HetorusNL/isstt-impro-announcer/docs/reference/impro-desk.jpg

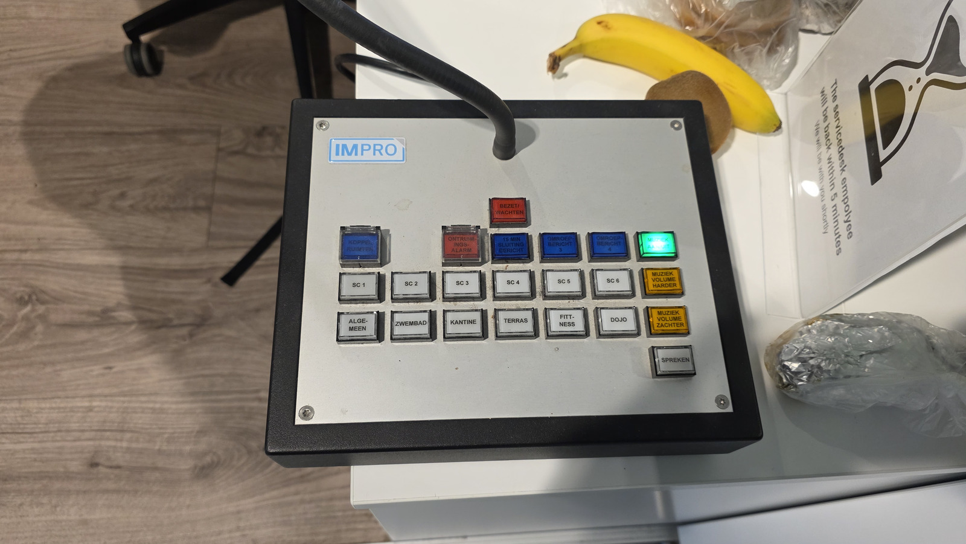
docs/reference/impro-desk.jpg
