HetorusNL/isstt-impro-announcer/hardware/cad/README.md

# Servo rig parts

Parametric OpenSCAD sources for the rig that presses buttons on the IMPRO desk from the outside. The numbers come from one file, `params.scad`. Most desk numbers are estimates from the photo, marked `// ESTIMATE` with what to measure. Change them there, re-render, reprint.

Render a part with `openscad -o part.stl part.scad`. STLs are not committed. Each part file lays its part in print orientation.

## Parts

| File | Part | Print |
|---|---|---|
| `edge_clamp.scad` | Padded clamp jaw, for both case sides (the same part turned 180 degrees) | 2 |
| `servo_carriage.scad` | Module carriage: bolts to a rail face, keyed in the slot | 4 |
| `servo_bracket.scad` | Module bracket: holds the servo and plunger guide, slides up and down the carriage | 4 |
| `servo_cam.scad` | Cam on the servo horn | 4 |
| `servo_plunger.scad` | Plunger between cam and button | 4 + spare |
| `tensioner_block.scad` | Tensioner block on the rail outside each post, for both sides (the same part turned 180 degrees) | 2 |
| `tensioner_pad.scad` | Tensioner pressure pad, bridges the slot in the post | 2 |
| `tensioner_collar.scad` | Stop collar under the push bolt head, sets the squeeze | 2 + spare |
| `squeeze_gauge.scad` | Go/no-go feeler gauge for the post gap, one for both sides | 1 |
| `end_cap.scad` | Press-fit end cap: 2 rail ends, 2 post bottoms | 4 + spare |
| `speaker_cradle.scad` | ER-151 cradle, arm and fixed half of the tube clamp | 1 |
| `speaker_clamp_cap.scad` | Removable half of the tube clamp | 1 |
| `../replica/replica_panel.scad` | Replica of the desk top | 1 |
| `../replica/test_button_plunger.scad` | Test button cap and snap stem | 4 |
| `../replica/test_button_leaf.scad` | Test button leaf spring | 4 + spare |
| `../replica/alarm_cover.scad` | Dummy flip cover | 2 |
| `frame_assembly.scad` | The whole rig. Not printed: a picture and the safety checks | - |
| `params.scad`, `lib.scad` | All dimensions; shared geometry | - |

## Print settings (Bambu Lab H2D)

| Setting | Structural parts (clamps, carriages, brackets, tensioner blocks and pads) | Other parts |
|---|---|---|
| Material | PETG (PLA also works, but creeps under the clamp load in a warm room) | PETG or PLA |
| Layer height | 0.2 mm | 0.2 mm |
| Walls | 5 | 3 |
| Top and bottom layers | 6 | 4 |
| Infill | 40 % gyroid | 15 % |
| Supports | None. See the tensioner block note | Only for `speaker_cradle.scad`, under the cups |

Print the tensioner block standing on its outer end, as its file lays it out. Slicing it shows three short bridges and no other overhang: the shoulder over the head slot (10.7 mm), the ceiling of the T-nut pocket (10.6 mm), and the top of the horizontal rail bolt hole (about 6 mm). The shoulder carries the push load, and it bends along its bridge strands, which is the strong direction. It has a 0.2 mm skin closing the bolt hole so the bridge prints whole: drill it out with a 5.5 mm drill (`m5_clear`). Check the collar thickness with calipers: it should be 2.2 mm, at 0.2 mm layers.

Print the gauge as laid out, so the blade thickness is in the print plane. Check both blades with calipers: go 10.45 mm, no-go 11.05 mm. If one is more than 0.1 mm off, sand it or reprint.

Print the replica open side down. The plate bridges between the ribs. The leaf springs need 100 % infill and must lie flat, so the leaf thickness is a whole number of layers. Print the plungers and the cam with 5 walls: they carry the press force.

## Cutting the extrusion

From the 1 m 2020 profile, with the default parameters:

- 1 rail, `rail_len` = **325.4 mm**
- 2 posts, `post_len` = **90.4 mm** each

That leaves about 490 mm spare. These lengths change when the desk is measured: run `openscad -o /tmp/a.stl frame_assembly.scad` and read them from the `ECHO` lines. Cut after measuring the desk.

## Assembly

**The T-nuts are slide-in: they only enter from a profile end.** Insert every nut you need, M5 and M4, **before** fitting corner brackets or end caps. If you miss one, the joint has to come apart.

Count of M5 slide-in nuts, with the default four modules:

| Where | Slot | Nuts |
|---|---|---|
| Rail | Back face (towards the SC row) | 3, one per SC module |
| Rail | Front face (towards SPREKEN) | 1 |
| Rail | Bottom slot, outermost at each end, for the tensioner blocks | 2 |
| Each post | Inner face, for the clamp jaw | 2 per post, so 4 |
| Module carriages | Pocket for the height bolt | 4 |
| Tensioner blocks | Pocket for the push bolt | 2 |
| Speaker clamp | Pockets | 2 |
| **Total** | | **18 of the 20 ordered** |

The corner brackets bring their own hardware, which is not in this count: M4x8 bolts and M4 slide-in nuts, 2 of each per bracket, so **8 M4 nuts on top of the 18 M5**. One nut of each bracket goes in the rail's bottom slot and the other in a post's side slot. Insertion order per slot:

| Slot | Enter from | Order |
|---|---|---|
| Rail bottom, from each end | That rail end | Inner bracket M4, then outer bracket M4, then the tensioner M5 last, so it is outermost |
| Post inner face (the jaw side) | Post bottom | Bracket M4 first, so it is nearest the rail, then the 2 jaw M5 |
| Post outer face | Post bottom | Bracket M4 only |

Use M5x10 for every printed part, including the tensioner. M5x8 leaves too little thread in the T-nut there.

Cut these pads from the sheet, slightly oversize so they press in:

| Pad | Size | Quantity |
|---|---|---|
| Jaw side | 30 x 22 mm | 2 |
| Under the lip | 30 x 7 mm | 2 |
| Plunger tip dot | 5 x 5 mm, press fit in the 4.5 mm recess, stands 1 mm proud | 4 |

The side pads and tip dots stay in by the press fit. The under-lip pad hangs upside down while the frame is lowered: a dab of removable tack on the pad-to-jaw side only is fine. Never put anything on the side that faces the desk.

1. Cut the rail and posts, then fit the nuts above, including the 8 M4 bracket nuts.
2. Join each post's top end to the rail's bottom face with 2 corner brackets, one on each side of the post, with the M4x8 bolts. Tighten the bolts into the post. Leave the bolts into the rail loose, so the posts slide along the rail. The bracket's centring lips sit in the slot, so a loose bracket still slides along the rail.
3. Press the end caps into the rail ends and post bottoms.
4. Bolt a jaw to each post's inner face with 2 M5x10, key in the slot, then push in the pads. No adhesive. The pad covers the bolt heads, so take it out to adjust the jaw.
5. Tensioner, one per side: drill out the skin in the shoulder hole. Slide a T-nut into the block's pocket. Put the stop collar on an M5x10 under its head, and thread the bolt through the shoulder into the nut. Put the pad's stub in the socket. Bolt the block to the rail's bottom slot with an M5x10, key in the slot, with a key's long arm up through the head slot. Keep it loose for now.
6. Set the squeeze, without the modules. See "Setting the squeeze".
7. Module: trim a stock single horn to `horn_stub` (7.5 mm from the axis). Drop the plunger into the guide from above, with the dot in its tip. Fit the servo from the back with the ears on the back face and the servo's own screws. Fit the horn and the cam with the horn screw. If that screw is too short with the cam fitted, use M2x8: check on one servo first.
8. Carriage on rail: M5x10 into a T-nut, key in the slot. Bracket on carriage: M5x10 through the slot into a T-nut in the pocket. The slot also gives a hex key access to the rail bolt, so a module can slide along the rail without taking it apart.
9. Slide each module over its button. With the eccentric pointing up, which is the cam's clear position, adjust the height so that the plunger rests on the cap with about 1 mm gap to the cam. Do not set this at servo angle 90: see "Cam calibration".

Module height adjustment is +6 mm and -3 mm: further down, the guide touches the cap.

Modules reach rows 1 and 3 on any column, so the SC row and the SPREKEN row. They cannot reach row 2 (ALGEMEEN to MUZIEK ZACHTER), because the rail runs directly above it. `params.scad` fails the render if you list a button there.

## Setting the squeeze

The clamping force comes from compressing the side pads by `pad_squeeze`, **0.8 mm per side**, which is one full turn of the push bolt. The pad is hidden, so its compression cannot be measured. The stop collar sets it instead, from a defined start, and a gauge checks the result.

| Post inner face to case wall, each side | Meaning |
|---|---|
| 11.5 mm | Pad just touching: the start |
| **10.7 mm** | **Target: the collar has seated** |
| 10.0 mm | Jaw plastic touches the case. **Never go this far: it can mark the desk.** |

These follow the measured `case_w`, and `frame_assembly.scad` echoes them.

1. Lower the frame over the desk with the lips resting on the rim. The bolts into the rail stay loose, on all 4 corner brackets. The bracket's centring lips sit in the slot: a loose bracket still slides along the rail, which steps 3 and 5 rely on.
2. Back off each push bolt by at least one full turn from the collar, and push the pad fully into its block.
3. Bring each post inward by hand until its pad just touches the case wall: the post stops sliding freely. Do not press into the foam.
4. Slide each block along the rail until its pad touches the post, without moving the post. Tighten the block's rail bolt with the long arm of a 3 mm hex key, up through the head slot. The handle swings below the block.
5. Turn the push bolts in with the same key, from outside, along the rail. Take turns, a quarter turn per side, until each head seats on its collar and stops. From contact that is one turn, 0.8 mm. If you backed off further, the first turns do nothing, and the result is the same. A loose post tilts, because the bolt pushes above the pad, so keep the posts upright.
6. Lock the corner bracket bolts into the rail, with the key that fits the bracket bolts: they are M4x8, and the size is unconfirmed, probably 2.5 mm if button head and 3 mm if socket head. Reach the outer bracket's bolts with the key's short arm, from below, through the gap above the block's arm, with the long arm swinging out to the front or back. The CAD draws the bracket as a cube, so the real access may instead be from the side or through the window in the sloped face.
7. Check with the gauge at the front and back edge of each post. Hold it by the bar, flat face against the case wall, and push a blade gently up from below, between the case wall and the 5 mm of post that sticks out below the jaw. Turn it around for the other side.
   - **The GO blade must fit.** If it does not, the jaw plastic is too close: loosen the brackets and start again from step 2.
   - **The NO blade must not fit.** If it does, the pad is not compressed enough: start again from step 2.

If locking moved a post, the gauge shows it. Loosen, correct and measure again. If you have calipers that reach, you can also check the spacing of the post inner faces, 202.4 mm with the estimated `case_w`, just above the jaws and before fitting the modules. That check is optional.

The block only pushes, and the collar touches only the block and the bolt, so the screw cannot pass the limit however hard you turn it, but only with the collar fitted and as long as the start was right. Never run the push bolt without its collar: the collar is what stops the jaw plastic reaching the case.

**Foam take-up.** The tensioner stays fitted. If the foam relaxes, repeat the whole procedure from step 1, with the modules still on. The collar then sets 0.8 mm from the pad's new contact. Do not use a thinner collar: that is the one way to overshoot. If the GO blade no longer fits after this, the pad has taken a permanent set: replace it.

## Cam calibration

Fit the cam with the eccentric horizontal at servo angle 90 (the groove on the cam's face marks the eccentric). **Fit all modules with the eccentric on the same side**: neighbouring cams then never swing towards each other. Then calibrate with the GUI on the real button. Expect rest at about 135 and press at about 65; the numbers mirror depending on which side the eccentric points.

**Before the first connect with modules on the desk, set `rest` to about 135 and `press` to a safe angle close to it, for example 120, in `config.toml`, and keep the plungers out until one connect with that rest has happened.** The firmware also drives the servos to the rest in its flash at power-on, before the host sends any config (README in the repo root, "Last bench step"). At rest 90 the cam holds the plunger about 1.5 mm into the button's travel. The host sends the rest angle on every connect, and the failsafes go to it, so a wrong rest can keep a button pressed. The angles in `config.example.toml` (rest 90, press 60) are placeholders and do not suit the cam.

**Stop at the angle where the button just bottoms out.** Going further only makes the servo push against the stop and draw current. The servo can push about 50 N at the press angle, which is more than the pads hold down, so overdriving the press angle lifts the frame.

## The button pusher: why a cam

The brief allows a horn or an arm. A swinging arm has two problems at this pitch:

- With a module offset by an arm length, the arm of one module reaches the shaft of the next once the arm is longer than about 11 mm, and the stock horn is longer than that.
- With an arm that short, the pushing finger has to hang down far enough to clear the servo body, and it then slides 5 to 6 mm across the cap during the press.

So each module sits centred on its own column, and a cam on the horn pushes a plunger straight down in a guide. The cam's eccentricity (`arm_len`) is the effective arm length. This also takes up less room and gets a much better force margin.

## Stiffness and force

The requirement: holding SPREKEN, deflection < 0.5 mm, servo force margin at least 2x at the arm length used.

### Force margin at the default arm length

MG90S stall torque is about 2.2 kg.cm at 5 V (ESTIMATE). 2.2 kg.cm is 215.7 N.mm.

Press force 3 N (ESTIMATE) at arm length 2.5 mm, plus cam friction (mu 0.3 at radius 6.75 mm, ESTIMATE):

- Lever: 3 N x 2.5 mm = 7.5 N.mm
- Friction: 3 N x 0.3 x 6.75 mm = 6.1 N.mm
- Required torque: 13.6 N.mm

**Margin: 215.7 / 13.6 = 15.9x.** At 1.8 kg.cm, the low end of the listings, it is 13.0x. The 2x limit is reached at a press force of about 24 N. `params.scad` fails the render if the margin drops below 2.

### Deflection while holding SPREKEN

Estimates with press force 3 N; printed PETG E = 2000 N/mm2. The real test is the stiffness check under "Manual checks".

| Item | Calculation | Deflection |
|---|---|---|
| Rail bending | 2020, simply supported over 222.4 mm, load at the middle (worst case): F L^3 / 48 E I | 0.0014 mm |
| Module lower walls | Moment 3 N x 12 mm over 20 mm, two walls 2 x 10 mm | 0.012 mm |
| Module upper U section | Moment 3 N x 12 mm over 39 mm, shelf to height bolt, walls 2 x 11 mm (conservative: the plate also bears on the carriage) | 0.018 mm |
| Plunger compression | 3 N over 6 x 6 mm, 18.5 mm long | 0.001 mm |
| Pad shear | 1.5 N per side over 651 mm2 of 3 mm EVA, G = 0.5 N/mm2 (ESTIMATE) | 0.014 mm |
| **Sum** | | **about 0.05 mm** |

The bolted joints are not in that sum. Even at several times this figure, the budget is well inside 0.5 mm. Gear backlash at the cam is also small: 1 degree at 2.5 mm is 0.04 mm, against 0.35 mm on a 20 mm arm. The load keeps it taken up during a hold.

How the design gets there:

- **Both sides clamped:** the rail spans between two posts, one on each side of the case, so it never acts as a cantilever.
- **Extrusion against the press force:** the reaction pulls straight up the rail's cross-section and along the posts' length. A 2020 profile is square, so its strong axis is both axes (ESTIMATE I = 6900 mm4). No bending reaches a weak section. A printed rail would be many times less stiff.
- **Generous module walls and ribs:** each bracket is a U section whose side walls run from the plunger guide up past the rail, deep behind the servo plate. The servo plate carries the load in its own plane, and the screws in shear, not pull-out.
- **Metal joints:** 2 corner brackets per post.

### Clamp grip

The press force pushes the frame up, and friction at the pads holds it down. At 25 % compression the EVA gives about 0.05 N/mm2 (ESTIMATE, low end) over 651 mm2, so 33 N per side. With mu 0.5 (ESTIMATE) both pads hold 33 N. That is 11x the SPREKEN load, and 2.7x with all four buttons held at once, which is the safe upper limit: the normal peak is one button. The frame's own weight adds to this, and the lips stop it going down. `frame_assembly.scad` fails the render below 2x.

The asserts in `frame_assembly.scad` only run when that file is rendered, so render it before reprinting anything.

These figures are estimates, so the real test is the pull check under "Manual checks".

## Safety: covered buttons

*Ontruimingsalarm* and *Koppel ruimtes* have keep-out volumes in `params.scad`. They follow `alarm_xy` and `koppel_xy`, so a measured position moves the safety volume. They cover the flip cover, its swing, side room for fingers and hand room up to 120 mm. `frame_assembly.scad` shows them as translucent volumes and fails the render if the rail, a post, a clamp, a tensioner or a module enters one. `params.scad` also fails the render if a covered button is listed as actuated. Nothing may ever be mounted over them.

The nearest part is the SC 3 module, directly in front of the alarm. Its guide ends about 6 mm in front of the cover's lip. `lip_clearance_min` (4 mm) is only the minimum clearance from any part to the lip. It is not room for a finger: the hand has to come from above, over the rail and the modules, and down into the volume above the cover. None of this is proven. The asserts only check that parts stay out of a box, so only the cover check under "Manual checks" can show that the alarm is reachable.

If a measured `pitch_y` or `alarm_xy` trips the assert, the clearance is `pitch_y - cover_d / 2 - sleeve_half`. Measure `cover_d` first, then reduce `guide_wall` (down to about 1.6 mm) for a narrower nose. Don't just lower `lip_clearance_min`.

## Speaker holder

The ER-151 slides into the cradle from the open side, then a strap holds it. The strap goes through the slots in the beam and around the prism outside the driver area. Any velcro cable tie or elastic strap that fits works: the slots are 3 x 18.8 mm.

- The driver face points at the mic head, at `mic_dist` (default 40 mm, spec 30 to 50 mm).
- `mic_offset` is 0 for the mic centred between the drivers, or 27.5 for the mic in line with one driver.
- The cups only hold the prism ends, outside the drivers. The end walls have windows, and the sloped faces stay free, so the USB and 3.5 mm plugs fit wherever they turn out to be.
- The tube clamp takes `tube_d` plus a rubber or EVA lining of `tube_lining` per side. Tighten by hand: it must not mark the gooseneck.

**Check first:** the holder and speaker hang on the gooseneck, and a gooseneck may sag under the speaker. See the checklist.

## Test button

Choice: a **printed leaf spring**, no parts to buy. The cap sits on a split stem with snap barbs under the panel. The stem presses on a leaf whose root pushes into a tunnel under the panel.

The leaf is a cantilever, `k = E b t^3 / (4 L^3)`. `params.scad` calculates its thickness from `btn_force`, rounded to whole 0.2 mm layers. The default gives t = 1.4 mm and 3.1 N at full travel, but only if printed PETG really has E = 2000 N/mm2, which is an estimate.

**Calibrate it after printing:** cup + water/coins on the cap until the cap lands, then weigh. If it is off, change `tb_print_E` and reprint the leaf.

The cap landing on the panel is the hard stop, and it represents the button being actuated. Check it with a strip of paper under the cap: when the strip is trapped, the button is fully pressed.

## Manual checks, left for Tim

- [ ] Print the parts and the replica.
- [ ] Calibrate the test button force (see above).
- [ ] Measure the desk and replace every `ESTIMATE` in `params.scad` that matters for fit. Reprint.
- [ ] Check T-nut and servo fits on one printed carriage and bracket before printing all four.
- [ ] Render `frame_assembly.scad` before reprinting anything, so the safety and hold-down asserts run.
- [ ] **Hex key:** when the corner brackets arrive, fit one real bracket and try the key that fits the bracket bolts on its rail bolt, with a printed block in place, before printing all blocks. The real access may be from the side or through the window in the sloped face. The CAD draws the bracket as a cube, so the 2.8 mm `bracket_key_clearance` is an estimate.
- [ ] **Squeeze:** set and check it as in "Setting the squeeze". Jaw plastic never touches the case.
- [ ] **Case wall:** confirm the case side wall is flat and vertical where the pads sit.
- [ ] **Stiffness:** on the replica, hold SPREKEN with the servo at its press angle for 60 s. The paper strip stays trapped the whole time, and deflection measured at the rail or module is below 0.5 mm (feeler gauge or dial).
- [ ] **Force margin:** check again with the measured press force. Margin = stall torque / (force x (`arm_len` + 0.3 x `cam_r`)), at least 2x.
- [ ] **Hold-down:** on the real desk, pull the frame upward with a spring scale or a weighed pull, at least 2x the measured press force. It must not lift or slip. Repeat after the rig has been clamped for some hours.
- [ ] **Cover, replica:** with the rig on the replica, open the dummy flip cover by hand on the alarm and on Koppel ruimtes.
- [ ] **Cover, real desk:** with the full rig fitted, including speaker and mic, sit at the operator position. Using one hand, open the real cover and press the button. It passes only if you can do this. If it fails, the rig does not go in service like this. Fix it first: a narrower or chamfered nose on the SC1 and SC3 modules, or a lower wall of modules.
- [ ] **Hand volume:** the speaker, holder and mic stay out of the hand volume above both covers, also after any sag. Record the allowed mic position. Servo leads follow the routing rule in `wiring.md`.
- [ ] **Speaker:** mount the holder on the gooseneck and check it does not sag. Check the distance to the mic with a ruler.
