HetorusNL/isstt-impro-announcer/firmware/PROTOCOL.md

# Servo firmware protocol (NUCLEO-F767ZI / NUCLEO-F746ZG)

Build: `pio run -d firmware -e nucleo_f767zi` (or `-e nucleo_f746zg`); flash with `pio run -d firmware -e <env> -t upload`.

## Serial

- `Serial` at 115200 baud, 8N1. In the STM32duino core both Nucleo-144 variants
  (`variant_NUCLEO_F767ZI.h`, `variant_NUCLEO_F7x6ZG.h`) set `SERIAL_UART_INSTANCE 3`
  (USART3, PD8/PD9), which is wired to the ST-Link virtual COM port (`/dev/ttyACM0`).
- One command per line, terminated by `\n`. `\r` is ignored. Commands are case-insensitive.
- Lines longer than 64 characters are discarded and answered with `ERR too long`.
- Every received line, valid or not, counts as host activity for the watchdog.

## Commands

| Command | Reply | Effect |
|---|---|---|
| `PING` | `OK PONG` | Keep-alive. |
| `REST <ch> <deg>` | `OK` / `ERR flash` | Store rest angle (EEPROM, only if changed), attach channel, move to rest. `ERR flash`: flash readback mismatched; the rest is kept in RAM for this session only (the channel still moves to rest). |
| `ANGLE <ch> <deg>` | `OK` / `ERR no rest` | Move servo. Refused (no movement) if the channel has no stored rest, so every driven channel is covered by the failsafes. Send `REST` first. |
| `RELEASE <ch>` | `OK` / `ERR no rest` | Move channel to its stored rest. |
| `RELEASE ALL` | `OK` | Move every channel with a stored rest to rest. |
| `MAXHOLD <ms>` | `OK` | Max time away from rest (default 60000, 1..120000, else `ERR range`). |
| `WATCHDOG <ms>` | `OK` | Keep-alive timeout (default 2000, 1..10000, else `ERR range`). |

Channels are 0-7, degrees 0-180. Errors: `ERR args`, `ERR channel`, `ERR degrees`, `ERR value`, `ERR range`, `ERR flash`,
`ERR unknown command`, `ERR empty`, `ERR no rest`, `ERR too long`.

## Events (asynchronous lines)

- `EVT BOOT`: sent once after release-on-boot. `EVT BOOT IWDG` if the reset was caused by the hardware watchdog.
- `EVT WATCHDOG`: no line received for `WATCHDOG` ms. All channels with a stored rest go to rest.
  Fires once; re-armed by the next received line. Active from boot.
- `EVT MAXHOLD <ch>`: channel `<ch>` was away from its stored rest angle for longer than `MAXHOLD` ms
  (timed from when it left rest; further `ANGLE`s do not reset it). It is moved to rest.

A channel with no stored rest is never attached at boot and never driven by any failsafe.

## Failsafe layers

1. Software keep-alive watchdog (above).
2. Per-channel max hold (above).
3. Hardware watchdog (IWDG, about 500 ms), refreshed in `loop()`. If the firmware hangs the MCU resets
   and release-on-boot puts every servo with a stored rest back at rest.

## EEPROM

STM32 EEPROM emulation uses flash. Layout: byte 0 magic `0xB8` (`0xA1 ^ NUM_CH ^ (PIN_TABLE_VERSION * 17)`,
so it includes the layout version and a reflash with a different pin table ignores old rests), bytes 1-8
rest angle per channel (`0xFF` = none). The buffered API (`eeprom_buffer_fill`/`eeprom_buffer_flush`) is used and a flush happens
only when a value actually changes, so the host's `REST` for every actuator on each connect is normally
free. After each flush the bytes are read back; on mismatch the reply is `ERR flash` and the RAM value is
kept for this session. The readback invalidates the D-cache for the flash region first, because the
core enables the D-cache and the flash HAL does no cache maintenance. After `ERR flash` a repeated
`REST` with the same value rewrites and re-verifies, and it rewrites all channels from RAM.

A flash sector erase is slow (up to a few seconds on the F7) and **stalls the whole CPU**: the first
received RX byte is buffered, further bytes are lost, and servo pulses and SysTick stall too. Therefore:
the host must wait for `OK` after each `REST`, and should change a `REST` only while nothing is pressed.
The IWDG is relaxed to 5 s just around the flush.

LSI tolerance: the IWDG runs from the LSI RC oscillator, so the nominal 500 ms timeout can be about
340 ms and the 5 s flush timeout about 3.4 s in practice.

### NUCLEO-F746ZG limitation (spare board)

The core's variant sets `FLASH_DATA_SECTOR 11`, which does not exist on the F746 (8 sectors). To avoid
corrupting flash, the `nucleo_f746zg` env (`-DREST_RAM_ONLY`) never touches flash. Rests are kept in
RAM in a `.noinit` section, protected by a magic word (which includes a layout version: channel count
and pin table version) and a complemented copy of each rest; any mismatch discards all rests. They
survive an IWDG or soft reset, the NRST button and an ST-Link reset (release-on-boot then works), but
are not guaranteed to survive a power cycle. After power-on, assume nothing is driven until the host
sends `REST`, and `ANGLE` returns `ERR no rest` until then.

## Pin table (one table in `src/main.cpp`, `PINS[]`)

| Channel | Pin |
|---|---|
| 0 | D3 |
| 1 | D5 |
| 2 | D6 |
| 3 | D9 |
| 4 | D10 |
| 5 | D11 |
| 6 | D12 |
| 7 | D13 |

The core's Servo library uses a software timer (TIM7), so it can drive any of these digital pins.

## Power notes

- Run the board from the external 5 V rail via **E5V** with jumper **JP3 set to E5V**. This keeps the
  watchdog running when the laptop USB is unplugged.
- Servo rail ground **must be common** with the board GND.
- Put a **1000 uF** electrolytic capacitor across the servo supply rail (near the servos) to absorb
  current spikes that would otherwise brown out the MCU.

## Bench test (manual, left for Tim)

`pio device monitor -d firmware --echo`, one servo on channel 0. The announcer locks the port, so stop it first.

| Step | Expected | Result |
|---|---|---|
| `REST 0 90` | `OK`, servo at 90 | |
| `ANGLE 0 60` | `OK`, servo moves | |
| Stop typing for 2 s | `EVT WATCHDOG`, servo back at 90 | |
| `MAXHOLD 5000`, `ANGLE 0 60`, keep sending `PING` | `EVT MAXHOLD 0` after about 5 s, servo at 90 | |
| Power-cycle | `EVT BOOT`, servo at 90 | |
| Board on E5V: `ANGLE 0 60`, pull USB | Back at 90 within 2 s | |
| `REST 0 90` again (unchanged) | `OK` immediately (no flash write) | |
| Send a 100-char line | `ERR too long` | |
| `ANGLE 1 60` with no rest stored for ch 1 | `ERR no rest`, no movement | |
| `WATCHDOG 20000` / `MAXHOLD 200000` | `ERR range` | |
| `REST 0 30`, power-cycle (F767) | rest still 30 (flash readback OK) | |
| `REST 0 90` | `OK`, servo back at 90: the test rest is not left in flash | |
| **Last step:** set the final `rest` in `config.toml`, run `uv run announcer` once | `controller connected on` in the log, servo at the final rest | |

The last step matters because the rest in flash drives the servos at power-on, before the host sends any config (README, "Last bench step"). Keep the plungers out until it has happened.
