HetorusNL/isstt-impro-announcer/hardware/cad/end_cap.scad

// End cap for the 2020 profile, press fit. Print 4 plus spares.
// Print orientation: plate on the bed.
include <params.scad>
include <lib.scad>

end_cap();
