HetorusNL/isstt-impro-announcer/hardware/cad/squeeze_gauge.scad

// Go/no-go feeler gauge for the gap between post and case wall, one for both sides. Print 1.
// Print orientation: bar on the bed, blades up.
include <params.scad>
include <lib.scad>

squeeze_gauge();
