HetorusNL/isstt-impro-announcer/hardware/cad/tensioner_collar.scad

// Stop collar under the push bolt head: sets the squeeze, so it sets the post position. Print 2 + spare.
// Print orientation: flat. Thickness comes from params; check it with calipers.
include <params.scad>
include <lib.scad>

tensioner_collar();
