HetorusNL/isstt-impro-announcer/hardware/cad/tensioner_pad.scad

// Tensioner pressure pad: bridges the post's slot; its stub slides in the block. Print 2.
// Print orientation: plate on the bed.
include <params.scad>
include <lib.scad>

rotate([0, -90, 0]) tensioner_pad();
