HetorusNL/isstt-impro-announcer/tests/test_main.py

import asyncio
import shutil
import subprocess
import sys
import threading
import time
from datetime import datetime, timedelta
from pathlib import Path
from types import SimpleNamespace
from zoneinfo import ZoneInfo

import numpy as np
import pytest
import soundfile as sf

from announcer import config, inhibit
from announcer.audio.player import MockPlayer, SoundPlayer
from announcer.clock import RealClock, SimClock
from announcer.config import Actuator, Config, ConfigGuard
from announcer.controller.mock import MockController
from announcer.controller.serial_ctrl import SerialController
from announcer.engine import HistoryEntry
from announcer.gui import view
from announcer.main import build_runtime, parse_args, reset_sim_state
from announcer.model import Announcement, Session
from announcer.schedule.cupkit import CupkitSource
from announcer.schedule.filesource import FileSource

REPO = Path(__file__).resolve().parents[1]
TZ = ZoneInfo("Europe/Amsterdam")


@pytest.fixture
def cfg_path(tmp_path: Path) -> Path:
    path = tmp_path / "config.toml"
    shutil.copy(REPO / "config.example.toml", path)
    return path


def runtime(cfg_path: Path, *argv: str):
    return build_runtime(parse_args(["--config", str(cfg_path), *argv]))


# CLI


def test_cli_parses_sim_args(cfg_path: Path) -> None:
    rt = runtime(cfg_path, "--mock", "--sim-start", "2026-12-18T08:55", "--sim-speed", "60")
    assert isinstance(rt.clock, SimClock)
    assert rt.clock.start == datetime(2026, 12, 18, 8, 55, tzinfo=TZ)
    assert rt.clock.speed == 60
    assert isinstance(rt.ctrl, MockController)
    assert isinstance(rt.player, MockPlayer)
    assert rt.sim


def test_cli_defaults(cfg_path: Path) -> None:
    args = parse_args(["--config", str(cfg_path), "--mock"])
    assert args.port == 8080
    rt = build_runtime(args)
    assert isinstance(rt.clock, RealClock)
    assert isinstance(rt.player, SoundPlayer)
    assert not rt.sim
    assert rt.store_path == Path("state/schedule.json")


def test_sim_speed_1_plays_real_audio(cfg_path: Path) -> None:
    rt = runtime(cfg_path, "--mock", "--sim-start", "2026-12-18T08:55", "--sim-speed", "1")
    assert isinstance(rt.player, SoundPlayer)


def test_sim_start_alone_defaults_speed(cfg_path: Path) -> None:
    rt = runtime(cfg_path, "--mock", "--sim-start", "2026-12-18T08:55")
    assert isinstance(rt.clock, SimClock)
    assert rt.clock.speed == 60


def test_sim_store_path_differs_from_real(cfg_path: Path) -> None:
    real = runtime(cfg_path, "--mock")
    sim = runtime(cfg_path, "--mock", "--sim-start", "2026-12-18T08:55", "--sim-speed", "60")
    assert sim.store_path != real.store_path
    assert sim.store_path.parent != real.store_path.parent  # handled.json lives next to it
    assert sim.store_path == Path("state/sim/schedule.json")


def test_state_dir_overrides_store(cfg_path: Path, tmp_path: Path) -> None:
    rt = runtime(cfg_path, "--mock", "--sim-speed", "60", "--state-dir", str(tmp_path / "s"))
    assert rt.store_path == tmp_path / "s" / "schedule.json"
    assert rt.fresh_sim_state is False


def test_reset_sim_state_removes_only_handled(tmp_path: Path) -> None:
    store = tmp_path / "sim" / "schedule.json"
    store.parent.mkdir()
    store.write_text("{}")
    (store.parent / "handled.json").write_text("[]")
    reset_sim_state(store)
    assert store.exists()
    assert not (store.parent / "handled.json").exists()
    reset_sim_state(store)  # nothing to remove: no error


def test_source_override(cfg_path: Path) -> None:
    assert isinstance(runtime(cfg_path, "--mock", "--source", "file").source, FileSource)
    assert isinstance(runtime(cfg_path, "--mock", "--source", "cupkit").source, CupkitSource)
    assert isinstance(runtime(cfg_path, "--mock").source, CupkitSource)  # config kind


def test_source_override_does_not_change_config(cfg_path: Path) -> None:
    rt = runtime(cfg_path, "--mock", "--source", "file", "--sim-speed", "60")
    assert rt.cfg.schedule.kind == "cupkit"  # a GUI save must not persist CLI overrides
    assert rt.cfg.schedule.store == "state/schedule.json"


def test_without_mock_builds_serial_controller(cfg_path: Path) -> None:
    rt = runtime(cfg_path)
    assert isinstance(rt.ctrl, SerialController)
    assert not rt.ctrl.connected  # the port is only opened by connect() at startup


def test_bad_config_exits_with_message(tmp_path: Path) -> None:
    with pytest.raises(SystemExit, match="cannot read"):
        build_runtime(parse_args(["--config", str(tmp_path / "missing.toml"), "--mock"]))


# sleep inhibitor


class FakeProc:
    def __init__(self, argv: list[str], **kwargs: object) -> None:
        self.argv = argv
        self.terminated = False
        self.killed = False

    def terminate(self) -> None:
        self.terminated = True

    def kill(self) -> None:
        self.killed = True

    def wait(self, timeout: float | None = None) -> int:
        return 0


def test_inhibitor_spawns_and_kills(monkeypatch: pytest.MonkeyPatch) -> None:
    procs: list[FakeProc] = []

    def popen(argv: list[str], **kwargs: object) -> FakeProc:
        procs.append(FakeProc(argv, **kwargs))
        return procs[-1]

    monkeypatch.setattr(inhibit.subprocess, "Popen", popen)
    with inhibit.Inhibitor():
        assert procs[0].argv == [
            "systemd-inhibit",
            "--what=sleep:idle:handle-lid-switch",
            "--who=announcer",
            "--why=tournament announcements",
            "sleep",
            "infinity",
        ]
        assert not procs[0].terminated
    assert procs[0].terminated


def test_inhibitor_kills_if_terminate_hangs(monkeypatch: pytest.MonkeyPatch) -> None:
    class Stuck(FakeProc):
        def wait(self, timeout: float | None = None) -> int:
            if not self.killed:
                raise subprocess.TimeoutExpired("systemd-inhibit", timeout or 0)
            return 0

    procs: list[Stuck] = []
    monkeypatch.setattr(
        inhibit.subprocess, "Popen", lambda a, **k: procs.append(Stuck(a)) or procs[-1]
    )
    with inhibit.Inhibitor():
        pass
    assert procs[0].killed


def test_inhibitor_missing_warns_and_continues(
    monkeypatch: pytest.MonkeyPatch, caplog: pytest.LogCaptureFixture
) -> None:
    def popen(argv: list[str], **kwargs: object) -> None:
        raise FileNotFoundError(argv[0])

    monkeypatch.setattr(inhibit.subprocess, "Popen", popen)
    with inhibit.Inhibitor():
        pass
    assert "systemd-inhibit" in caplog.text


def test_inhibitor_helper_dies_when_app_is_killed() -> None:
    # A killed app runs no cleanup, and a helper left behind blocks the lid until reboot.
    app = subprocess.Popen(
        [
            sys.executable,
            "-c",
            "import time\n"
            "from announcer import inhibit\n"
            "inhibit.COMMAND = ['sleep', '300']\n"
            "with inhibit.Inhibitor() as i:\n"
            "    print(i._proc.pid, flush=True)\n"
            "    time.sleep(300)\n",
        ],
        stdout=subprocess.PIPE,
        text=True,
    )
    assert app.stdout is not None
    helper = int(app.stdout.readline())
    try:
        app.kill()
        app.wait()
        deadline = time.monotonic() + 5
        while time.monotonic() < deadline and Path(f"/proc/{helper}").exists():
            time.sleep(0.05)
        assert not Path(f"/proc/{helper}").exists(), "helper outlived the killed app"
    finally:
        app.stdout.close()
        subprocess.run(["kill", "-9", str(helper)], capture_output=True)


# GUI helpers


def make_cfg() -> Config:
    cfg = Config()
    cfg.actuators = {
        "SC1": Actuator(channel=0, rest=10, press=40),
        "SC2": Actuator(channel=1, rest=10, press=40),
        "SPREKEN": Actuator(channel=2, rest=10, press=40),
    }
    cfg.announce.halls = ["SC1"]
    return cfg


def test_hall_choices_exclude_spreken() -> None:
    assert view.hall_choices(make_cfg()) == ["SC1", "SC2"]


def test_fmt_countdown() -> None:
    assert view.fmt_countdown(-3) == "now"
    assert view.fmt_countdown(65.4) == "01:05"
    assert view.fmt_countdown(3 * 3600 + 61) == "3:01:01"


def test_fmt_age() -> None:
    now = datetime(2026, 12, 18, 9, 0, tzinfo=TZ)
    assert view.fmt_age(now, None) == "never"
    assert view.fmt_age(now, datetime(2026, 12, 18, 8, 59, 48, tzinfo=TZ)) == "12 s ago"
    assert view.fmt_age(now, datetime(2026, 12, 18, 8, 55, tzinfo=TZ)) == "5 min ago"


def test_history_rows_newest_first_and_replayable() -> None:
    t = [datetime(2026, 12, 18, 9, m, tzinfo=TZ) for m in range(5)]
    a, b, c = ("match_start", "A"), ("match_end", "B"), ("match_start", "C")
    rows = view.history_rows(
        [
            HistoryEntry(t[0], a, "skipped", "late"),
            HistoryEntry(t[1], b, "failed", "boom"),
            HistoryEntry(t[2], c, "played"),
            HistoryEntry(t[3], a, "played"),  # a was played now later
        ]
    )
    assert [r.key for r in rows] == [a, c, b, a]
    assert [r.replayable for r in rows] == [False, False, True, False]


async def test_apply_config_saves_and_reloads(tmp_path: Path) -> None:
    class FakeEngine:
        def __init__(self) -> None:
            self.cfg = make_cfg()
            self.reloaded: list[Config] = []

        async def reload_config(self, cfg: Config) -> None:
            self.reloaded.append(cfg)

    engine = FakeEngine()
    player = SoundPlayer(None, 1.0)
    path = tmp_path / "config.toml"

    def edit(cfg: Config) -> None:
        cfg.announce.chime_seconds = 4.5
        cfg.audio.volume = 0.5

    assert await view.apply_config(engine, path, edit, player) is None
    assert config.load(path).announce.chime_seconds == 4.5
    assert engine.reloaded[0].announce.chime_seconds == 4.5
    assert engine.cfg.announce.chime_seconds == 3.0  # the engine swaps it in itself
    assert player.volume == 0.5

    def bad(cfg: Config) -> None:
        cfg.announce.halls = ["NOPE"]

    error = await view.apply_config(engine, path, bad, player)
    assert error is not None and "NOPE" in error
    assert len(engine.reloaded) == 1
    assert engine.cfg.announce.halls == ["SC1"]  # live config untouched


async def test_apply_config_reports_reload_failure(tmp_path: Path) -> None:
    class FailingEngine:
        cfg = make_cfg()

        async def reload_config(self, cfg: Config) -> None:
            raise RuntimeError("controller gone")

    error = await view.apply_config(FailingEngine(), tmp_path / "c.toml", lambda c: None)
    assert error is not None and "controller gone" in error


class FakeTalkEngine:
    def __init__(self) -> None:
        self.calls: list[str] = []
        self.gate = asyncio.Event()

    async def talk_start(self, halls: tuple[str, ...]) -> None:
        self.calls.append("start")
        await self.gate.wait()  # waiting for the desk lock

    async def talk_stop(self) -> None:
        self.calls.append("stop")


async def test_talk_hold_release_before_start_returns_still_stops() -> None:
    engine = FakeTalkEngine()
    talk = view.TalkHold(engine)
    talk.press(["SC1"])
    await asyncio.sleep(0)
    talk.press(["SC1"])  # touchstart + mousedown: one talk
    await talk.release()
    engine.gate.set()
    await talk.wait()
    assert engine.calls == ["start", "stop"]  # stop reaches the talk waiting for the lock


async def test_talk_hold_release_before_task_runs_never_starts() -> None:
    engine = FakeTalkEngine()
    talk = view.TalkHold(engine)
    talk.press(["SC1"])
    await talk.release()
    await talk.wait()
    assert engine.calls == []  # talk_start never called, nothing to stop


async def test_talk_hold_release_without_press_does_nothing() -> None:
    engine = FakeTalkEngine()
    talk = view.TalkHold(engine)
    await talk.release()  # mouseleave / tab closed without a press
    talk.press(["SC1"])
    await asyncio.sleep(0)
    await talk.release()
    await talk.release()  # mouseup then mouseleave
    engine.gate.set()
    await talk.wait()
    assert engine.calls == ["start", "stop"]


async def test_talk_hold_does_not_stop_another_tabs_talk() -> None:
    class Busy(FakeTalkEngine):
        async def talk_start(self, halls: tuple[str, ...]) -> None:
            self.calls.append("start")
            raise RuntimeError("a talk is already active")  # tab A is talking

    engine = Busy()
    tab_b = view.TalkHold(engine)
    tab_b.press(["SC1"])
    await tab_b.wait()
    assert tab_b.error == "a talk is already active"
    await tab_b.release()  # mouseup / disconnect of tab B
    assert engine.calls == ["start"]  # no talk_stop: tab A keeps talking


async def test_talk_hold_records_error() -> None:
    class Stopped(FakeTalkEngine):
        async def talk_start(self, halls: tuple[str, ...]) -> None:
            raise RuntimeError("engine stopped")

    talk = view.TalkHold(Stopped())
    talk.press(["SC1"])
    await talk.wait()
    assert talk.error == "engine stopped"


class FakeServos:
    def __init__(self) -> None:
        self.calls: list[tuple[str, str, int | None]] = []
        self.gate: asyncio.Event | None = None
        self.fail = False

    async def set_angle(self, button: str, angle: int) -> None:
        if self.gate is not None:
            await self.gate.wait()
        if self.fail:
            raise RuntimeError("serial gone")
        self.calls.append(("set_angle", button, angle))

    async def release(self, button: str) -> None:
        self.calls.append(("release", button, None))

    async def release_all(self) -> None:
        self.calls.append(("release_all", "", None))


async def test_calibrator_latest_value_wins() -> None:
    servos = FakeServos()
    servos.gate = asyncio.Event()
    cal = view.Calibrator(servos, lambda: False)
    cal.jog("SC1", 20, 10)
    await asyncio.sleep(0)  # 20 is in flight
    for angle in (25, 30, 35):
        cal.jog("SC1", angle, 10)
    servos.gate.set()
    await cal.wait()
    assert servos.calls == [("set_angle", "SC1", 20), ("set_angle", "SC1", 35)]
    assert cal.away == {"SC1": 35}


async def test_calibrator_spreken_press_returns_to_rest() -> None:
    servos = FakeServos()
    cal = view.Calibrator(servos, lambda: False, return_s=0.05)
    cal.jog("SPREKEN", 60, 90)
    await asyncio.sleep(0.03)
    cal.jog("SPREKEN", 55, 90)  # still moving: the return is postponed
    await asyncio.sleep(0.03)
    assert servos.calls[-1] == ("set_angle", "SPREKEN", 55)
    assert cal.away == {"SPREKEN": 55}
    await cal.wait()
    assert servos.calls[-1] == ("set_angle", "SPREKEN", 90)
    assert cal.away == {}


async def test_calibrator_other_presses_stay() -> None:
    servos = FakeServos()
    cal = view.Calibrator(servos, lambda: False, return_s=0.01)
    cal.jog("SC1", 40, 10)
    await asyncio.sleep(0.05)
    assert servos.calls == [("set_angle", "SC1", 40)]
    assert cal.away == {"SC1": 40}
    assert await cal.tap("SC1", 40, 10, press_ms=1, release_ms=1)
    assert cal.away == {}


async def test_calibrator_release_all_clears_and_cancels() -> None:
    servos = FakeServos()
    cal = view.Calibrator(servos, lambda: False, return_s=0.02)
    cal.jog("SPREKEN", 60, 90)
    cal.jog("SC1", 40, 10)
    assert await cal.release_all()
    await asyncio.sleep(0.05)
    assert servos.calls == [("release_all", "", None)]
    assert cal.away == {}


async def test_calibrator_refuses_while_busy() -> None:
    servos = FakeServos()
    busy = [True]
    cal = view.Calibrator(servos, lambda: busy[0], return_s=0.01)
    assert not cal.jog("SC1", 40, 10)
    assert not await cal.tap("SC1", 40, 10)
    assert not await cal.release_all()  # e.g. tab closed during a session
    assert servos.calls == []
    busy[0] = False
    cal.jog("SPREKEN", 60, 90)
    await asyncio.sleep(0)
    busy[0] = True  # a session takes the desk before the return: it releases SPREKEN itself
    await cal.wait()
    assert servos.calls == [("set_angle", "SPREKEN", 60)]
    assert cal.away == {}


async def test_calibrator_records_errors() -> None:
    servos = FakeServos()
    servos.fail = True
    cal = view.Calibrator(servos, lambda: False)
    cal.jog("SC1", 40, 10)
    await cal.wait()
    assert cal.error is not None and "serial gone" in cal.error
    assert cal.away == {}


class FakeSoundDevice:
    """sounddevice whose wait() only returns after stop(), like a device that never finishes."""

    def __init__(self) -> None:
        self.stopped = threading.Event()
        self.playing = threading.Event()

    def play(self, data: object, samplerate: int, device: object = None) -> None:
        self.playing.set()

    def wait(self) -> None:
        assert self.stopped.wait(5.0)

    def stop(self) -> None:
        self.stopped.set()


async def test_sound_player_cancel_stops_device_off_the_event_loop(
    tmp_path: Path, monkeypatch: pytest.MonkeyPatch
) -> None:
    device = FakeSoundDevice()
    monkeypatch.setitem(sys.modules, "sounddevice", device)
    loop_thread = threading.current_thread()
    stop_thread: list[threading.Thread] = []
    orig_stop = device.stop

    def stop() -> None:
        stop_thread.append(threading.current_thread())
        orig_stop()

    device.stop = stop
    clip = tmp_path / "clip.wav"
    sf.write(clip, np.zeros(800, dtype="int16"), 8000)
    with pytest.raises(TimeoutError):
        await asyncio.wait_for(SoundPlayer(None, 1.0).play(clip), 0.05)
    deadline = time.monotonic() + 2.0
    while not device.stopped.is_set():
        assert time.monotonic() < deadline
        await asyncio.sleep(0.001)
    assert device.playing.is_set()
    assert stop_thread[0] is not loop_thread  # a hung PortAudio cannot block the SPREKEN release


# dashboard banner, SPREKEN rest guard (final review)


def _banner_engine(error: str | None = None, skipped: int = 0) -> SimpleNamespace:
    return SimpleNamespace(source_error=error, source_skipped=skipped)


def test_banner_empty_when_all_is_well() -> None:
    assert view.banner_text(_banner_engine()) is None


def test_banner_shows_error_and_skipped_count() -> None:
    assert view.banner_text(_banner_engine("boom")) == "Schedule source error: boom"
    assert "2 time blocks" in view.banner_text(_banner_engine(skipped=2))
    both = view.banner_text(_banner_engine("boom", 1))
    assert "boom" in both and "1 time block " in both


def test_safe_spreken_rest() -> None:
    assert view.safe_spreken_rest(135, 65, 130) == 135
    assert view.safe_spreken_rest(75, 65, 130) == 75  # exactly the minimum: allowed
    assert view.safe_spreken_rest(70, 65, 130) == 130  # too close: the saved rest
    assert view.safe_spreken_rest(65, 65, 130) == 130


async def test_apply_config_refuses_spreken_rest_near_press_and_bad_halls(tmp_path: Path) -> None:
    class FakeEngine:
        def __init__(self) -> None:
            self.cfg = make_cfg()
            self.reloaded: list[Config] = []

        async def reload_config(self, cfg: Config) -> None:
            self.reloaded.append(cfg)

    engine = FakeEngine()
    path = tmp_path / "config.toml"

    def near(cfg: Config) -> None:
        cfg.actuators["SPREKEN"].rest = cfg.actuators["SPREKEN"].press + 5

    def no_halls(cfg: Config) -> None:
        cfg.announce.halls = []

    assert "SPREKEN" in (await view.apply_config(engine, path, near))
    assert "at least one" in (await view.apply_config(engine, path, no_halls))
    assert engine.reloaded == [] and not path.exists()


# calibration tap, preview guard, queue, config guard, session times (final review I2, I7, I9, I11)


async def test_calibrator_tap_uses_the_slider_values_not_the_stored_rest() -> None:
    servos = FakeServos()
    cal = view.Calibrator(servos, lambda: False)
    cal.away["SC1"] = 50
    assert await cal.tap("SC1", 70, 120, press_ms=1, release_ms=1)
    assert servos.calls == [("set_angle", "SC1", 70), ("set_angle", "SC1", 120)]
    assert cal.away == {}


async def test_calibrator_tap_returns_to_rest_when_cancelled() -> None:
    servos = FakeServos()
    cal = view.Calibrator(servos, lambda: False)
    task = asyncio.create_task(cal.tap("SPREKEN", 70, 120, press_ms=10_000))
    while not servos.calls:
        await asyncio.sleep(0.001)
    task.cancel()
    with pytest.raises(asyncio.CancelledError):
        await task
    assert servos.calls == [("set_angle", "SPREKEN", 70), ("set_angle", "SPREKEN", 120)]


async def test_calibrator_tap_falls_back_to_release_when_return_fails() -> None:
    class ReturnFails(FakeServos):
        async def set_angle(self, button: str, angle: int) -> None:
            if angle == 120:
                raise RuntimeError("serial busy")
            await super().set_angle(button, angle)

    servos = ReturnFails()
    cal = view.Calibrator(servos, lambda: False)
    await cal.tap("SPREKEN", 70, 120, press_ms=1, release_ms=1)
    assert servos.calls == [("set_angle", "SPREKEN", 70), ("release", "SPREKEN", None)]


async def test_calibrator_abort_drops_pending_moves_and_return() -> None:
    servos = FakeServos()
    servos.gate = asyncio.Event()
    cal = view.Calibrator(servos, lambda: False, return_s=0.01)
    cal.jog("SPREKEN", 60, 90)
    cal.jog("SC1", 40, 10)
    await asyncio.sleep(0)
    cal.away["SC2"] = 40
    cal.abort()
    servos.gate.set()
    await asyncio.sleep(0.03)
    assert servos.calls == []
    assert cal.away == {}


def _session(start: datetime, kind: str = "match_start") -> Session:
    return Session(start, (Announcement(due=start, kind=kind),), ("SC1",))


NOW = datetime(2026, 12, 19, 8, 0, tzinfo=TZ)


def _preview_engine(upcoming=(), current=None, talking=False) -> SimpleNamespace:
    return SimpleNamespace(upcoming=list(upcoming), current=current, talking=talking)


def test_preview_allowed_when_desk_free_and_nothing_near() -> None:
    assert view.preview_refusal(_preview_engine(), NOW) is None
    later = NOW + timedelta(seconds=view.PREVIEW_GUARD_S + 1)
    assert view.preview_refusal(_preview_engine([_session(later)]), NOW) is None


def test_preview_refused_while_desk_busy() -> None:
    assert "desk" in view.preview_refusal(_preview_engine(talking=True), NOW)
    assert "desk" in view.preview_refusal(_preview_engine(current=_session(NOW)), NOW)


def test_preview_refused_shortly_before_a_session() -> None:
    soon = NOW + timedelta(seconds=view.PREVIEW_GUARD_S - 1)
    assert "next session" in view.preview_refusal(_preview_engine([_session(soon)]), NOW)
    overdue = NOW - timedelta(seconds=5)
    assert "next session" in view.preview_refusal(_preview_engine([_session(overdue)]), NOW)


def test_session_times_show_start_and_due() -> None:
    due = datetime(2026, 12, 19, 9, 0, tzinfo=TZ)
    session = Session(due - timedelta(seconds=5), (Announcement(due=due, kind="match_start"),), ())
    assert view.fmt_session_times(session) == "Sat 08:59:55 (due 09:00:00)"


def test_queued_label_shows_text_and_halls() -> None:
    ann = Announcement(due=NOW, kind="manual_text", text="x" * 100)
    label = view.queued_label(Session(NOW, (ann,), ("SC1", "SC2")))
    assert "SC1, SC2" in label and "x" * 40 in label and "x" * 100 not in label


def test_cancel_queued_via_view() -> None:
    class Queue:
        def __init__(self) -> None:
            self.results = [True, False]

        def cancel_manual(self, session: object) -> bool:
            return self.results.pop(0)

    queue = Queue()
    assert view.cancel_queued(queue, object()) is None
    assert "already started" in view.cancel_queued(queue, object())


async def test_apply_config_refuses_when_file_changed_on_disk(tmp_path: Path) -> None:
    class FakeEngine:
        def __init__(self) -> None:
            self.cfg = make_cfg()
            self.reloaded: list[Config] = []

        async def reload_config(self, cfg: Config) -> None:
            self.reloaded.append(cfg)

    engine = FakeEngine()
    path = tmp_path / "config.toml"
    config.save(engine.cfg, path)
    guard = ConfigGuard(path)

    def edit(cfg: Config) -> None:
        cfg.announce.chime_seconds = 7.0

    assert await view.apply_config(engine, path, edit, None, guard) is None
    assert await view.apply_config(engine, path, edit, None, guard) is None  # own saves are fine
    assert len(engine.reloaded) == 2

    hand_edited = path.read_text() + "# by hand\n"
    path.write_text(hand_edited)
    error = await view.apply_config(engine, path, edit, None, guard)
    assert error is not None and "Restart" in error
    assert path.read_text() == hand_edited  # untouched
    assert len(engine.reloaded) == 2


def test_runtime_guards_the_config_it_loaded(cfg_path: Path) -> None:
    rt = runtime(cfg_path, "--mock")
    assert not rt.cfg_guard.changed()
    cfg_path.write_text(cfg_path.read_text() + "# by hand\n")
    assert rt.cfg_guard.changed()


async def test_mock_logs_button_actions_at_info(caplog: pytest.LogCaptureFixture) -> None:
    clock = SimClock(NOW, 1000)
    ctrl = MockController(clock, make_cfg().actuators)
    with caplog.at_level("INFO", logger="announcer.controller.mock"):
        await ctrl.hold("SPREKEN")
        await ctrl.release("SPREKEN")
    messages = [r.getMessage() for r in caplog.records]
    assert len(messages) == 2
    assert "hold SPREKEN" in messages[0] and "release SPREKEN" in messages[1]
    assert "2026-12-19" in messages[0]
