HetorusNL/isstt-impro-announcer/(commit log)

2026-11-01 docs: bill of materials
2026-11-01 fix: reject empty schedule files, log unparseable match lines
    [test_cupkit.py, test_filesource.py]
2026-11-01 feat: planner (slots, end times, merged sessions)
2026-11-01 fix: lost cancel in shielded release, deselect after fallback/error
    [test_sequencer.py]
2026-11-01 fix: deselect only halls that were selected
    [mock.py, test_sequencer.py]
2026-11-01 feat: engine (scheduling, pause, late/skip, persistence, manual queue)
    [test_engine.py, test_sequencer.py]
2026-11-01 docs: BOM power supply is a closed 5 V 4 A wall adapter
2026-11-01 fix: engine re-checks under lock, talk max-hold ends talk, pre-synth
    [test_engine.py]
2026-11-01 fix: guard pre-synth render errors, trial-render templates, rebuild tts on reload
    [test_config.py, test_engine.py]
2026-11-01 docs: BOM on-hand wiring, laptop-jack speaker, no USB sound card
2026-11-01 fix: calibration releases spreken, talk hold per tab, touch and slider handling
    [test_main.py, test_rehearsal.py]
2026-11-01 feat: STM32 servo firmware with watchdog, max hold, release on boot
2026-11-01 fix: firmware rejects ANGLE without rest, F746 RAM-only rest, flash readback
    [main.cpp]
2026-11-01 fix: invalidate dcache before flash verify, F746 noinit rests
    [main.cpp]
2026-11-01 fix: checksum noinit rests, layout version, flash dirty rebuild
    [main.cpp]
2026-11-01 docs: BOM order status (servos, power, extension leads ordered)
2026-11-01 fix: serial tap releases on cancel during press, narrower REST tolerance, bounded reads
    [serial_ctrl.py, test_config.py, test_serial_ctrl.py]
2026-11-02 docs: BOM frame hardware (M5, corner brackets) and delivery notes
2026-11-02 feat: parametric frame, replica, wiring
    [alarm_cover.scad, edge_clamp.scad, end_cap.scad, frame_assembly.scad, lib.scad, params.scad, replica_panel.scad, servo_bracket.scad]
2026-11-02 fix: clamp tensioner, measurable squeeze, alarm keep-out from alarm_xy
    [frame_assembly.scad, lib.scad, params.scad, replica_panel.scad, tensioner_block.scad, tensioner_pad.scad]
2026-11-02 fix: tensioner stop collar, feeler gauge, bracket key access
    [frame_assembly.scad, lib.scad, params.scad, squeeze_gauge.scad, tensioner_block.scad, tensioner_collar.scad]
2026-11-02 fix: scheduled sessions wait out disconnects, bounded audio, lost holds fail
    [base.py, mock.py, serial_ctrl.py, test_engine.py]
2026-11-02 fix: reject alarm-like names, validate halls, rest clear of press
    [serial_ctrl.py, test_config.py, test_cupkit.py, test_engine.py]
2026-11-02 feat: emergency stop, safe preview and calibration tap, queue visible
2026-11-02 fix: inhibit lid close
    [test_main.py]
2026-11-02 docs: first run, checklist ordering, bench rest
    [params.scad]
2026-11-02 fix: emergency stop clears queued manual texts
    [test_engine.py]
2026-11-02 docs: BOM foam order
2026-11-03 fix: end the sleep inhibitor when the app is killed
    A killed app runs no cleanup, so the systemd-inhibit helper stayed behind
    and blocked sleep and the lid until reboot. The helper now gets SIGTERM
    from the kernel when its parent dies.
    [test_main.py]
